Aqua-Lab-Boat-Team/WN-sensor_board/sensor_board.kicad_pcb

## KiCad design sensor_board.kicad_pcb (2026-11-14)

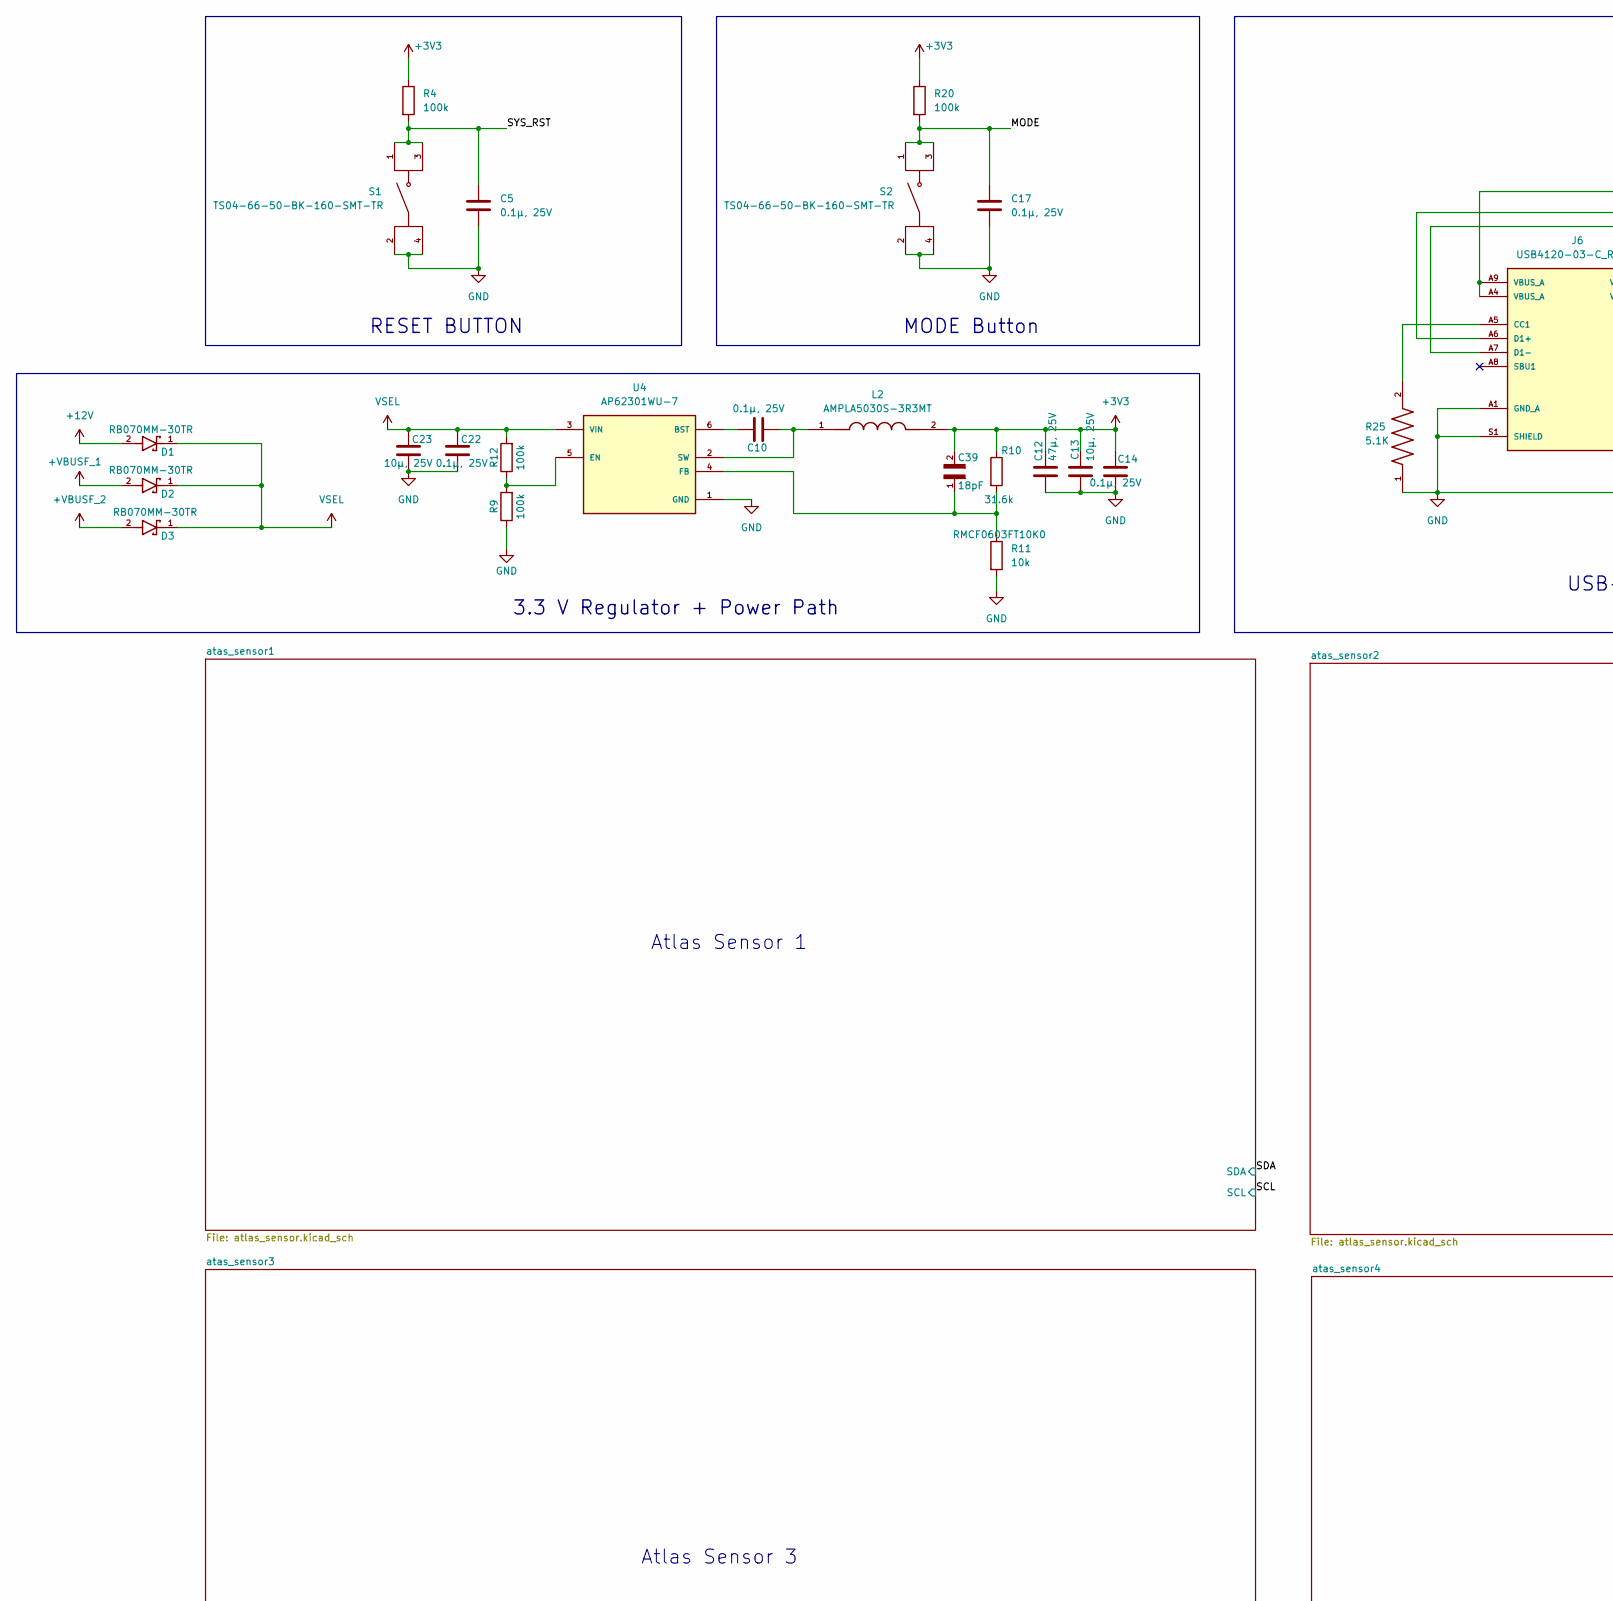
[picture p1: schematic sensor_board.kicad_sch, part in row 1, column 1]

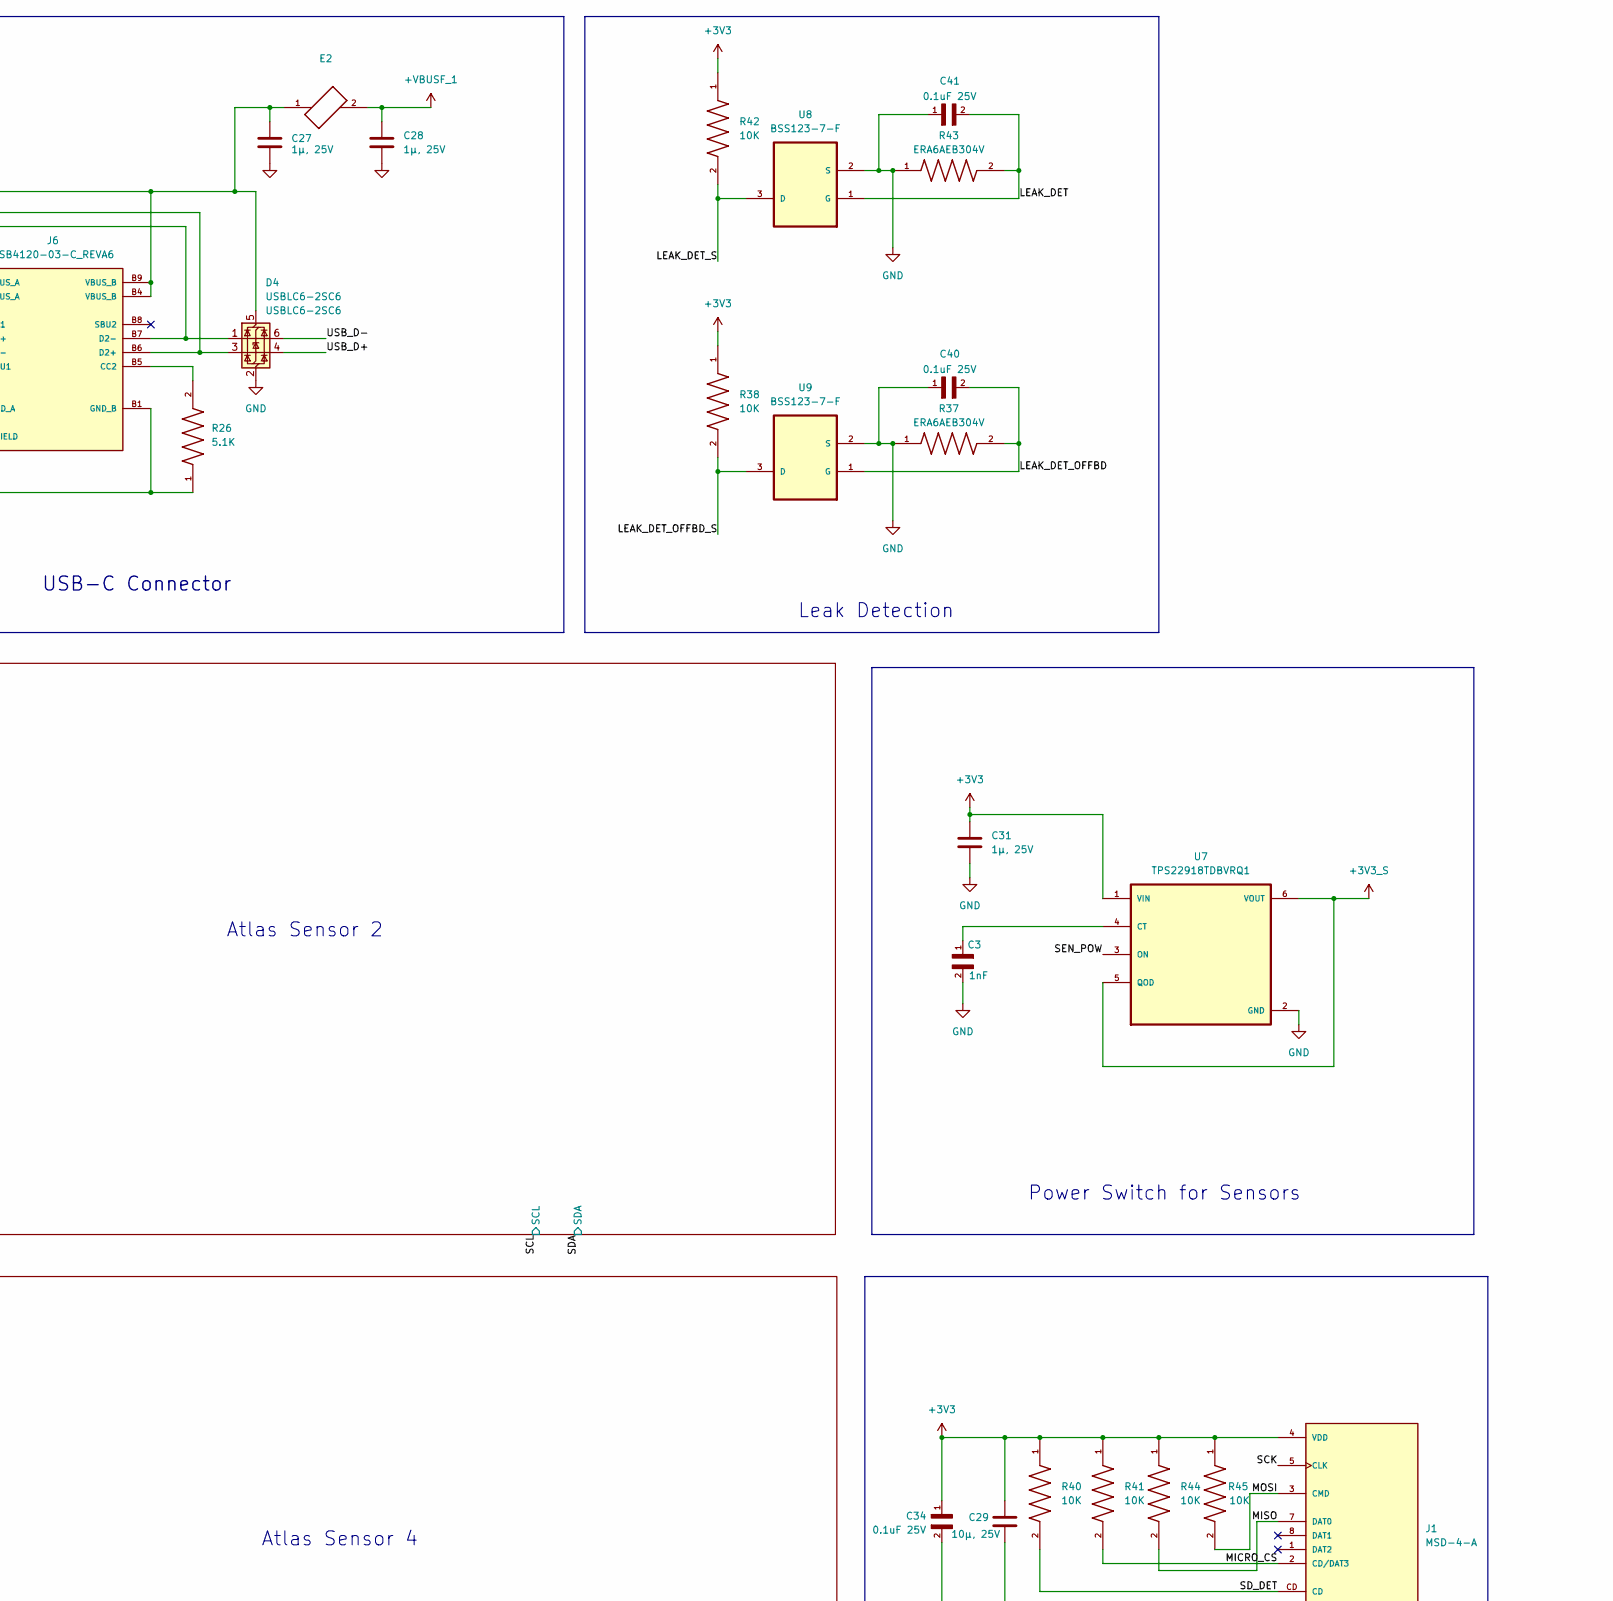
[picture p2: schematic sensor_board.kicad_sch, part in row 1, column 2]

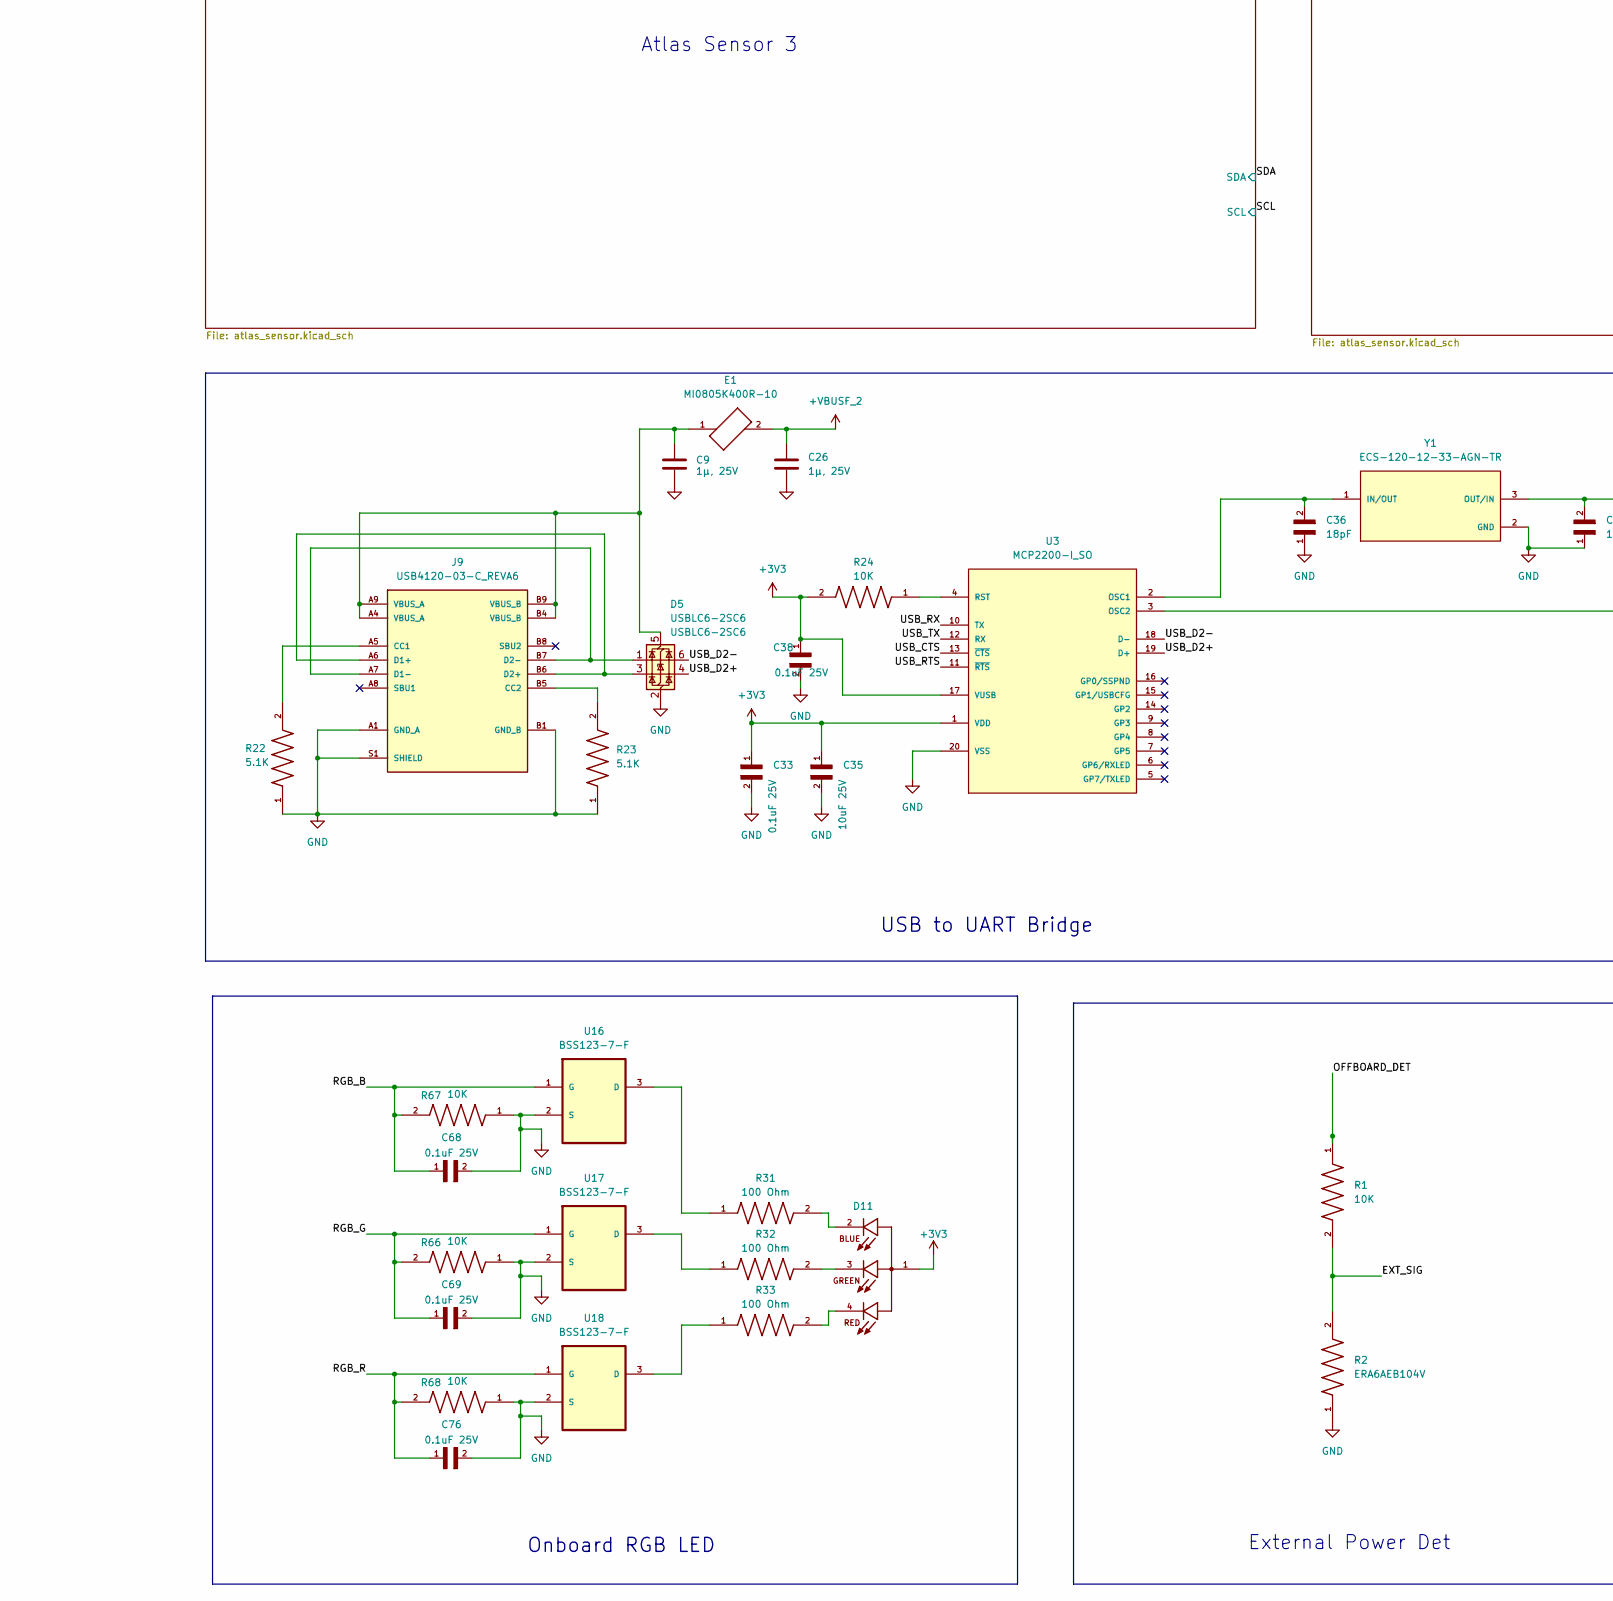
[picture p3: schematic sensor_board.kicad_sch, part in row 2, column 1]

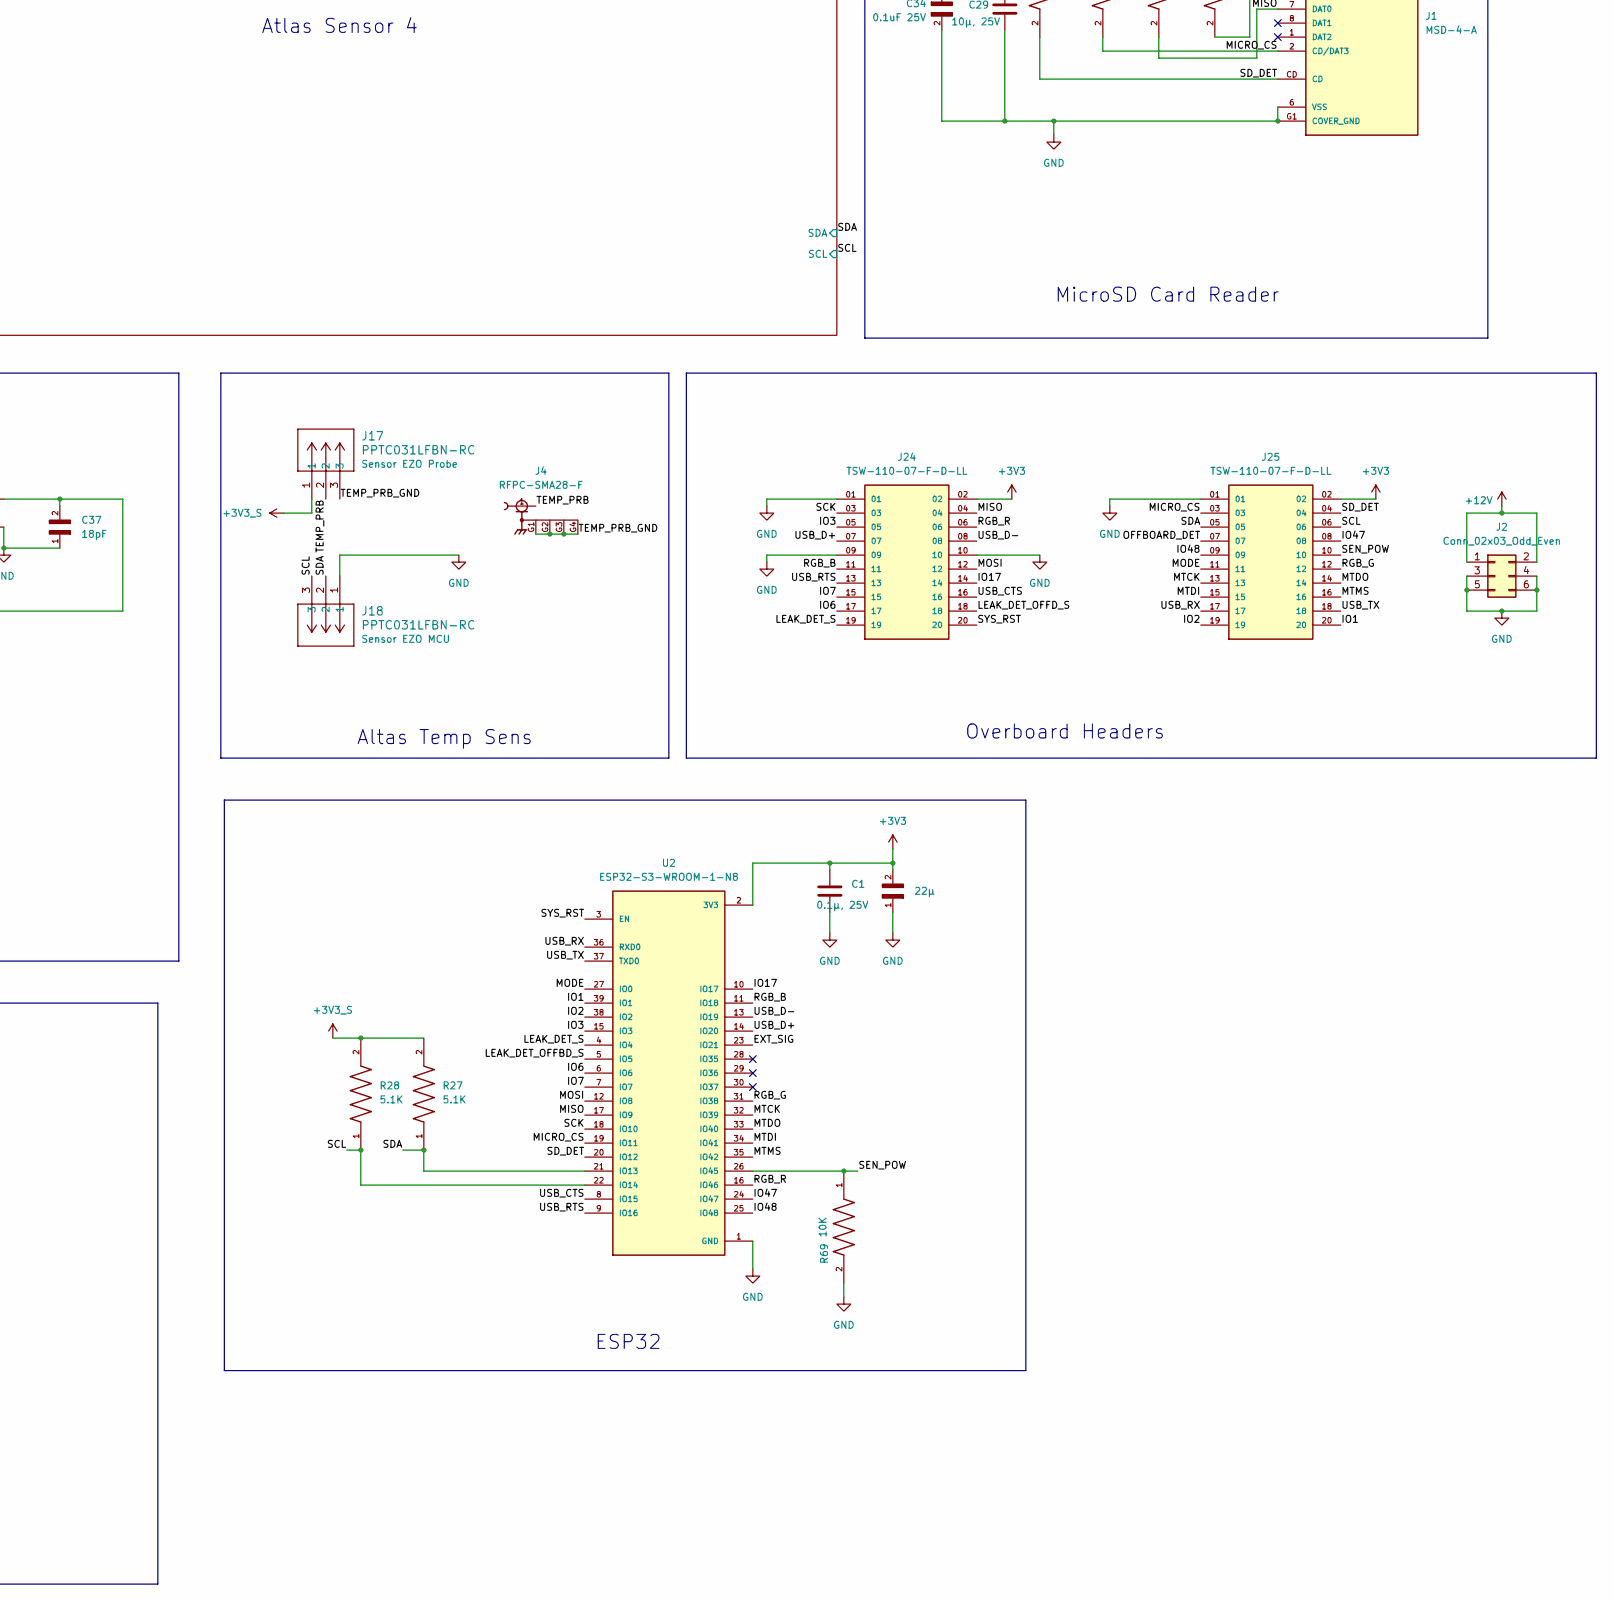
[picture p4: schematic sensor_board.kicad_sch, part in row 2, column 2]

Parts:
C1, C5, C10, C14, C17, C22: 0.1µ, 25V; CAPC2012X95N
C2: 22µ; CAPC1608X105N
C3: 1nF; CAPC1608X90
C9, C26, C27, C28, C31: 1µ, 25V; CAPC2012X145N
C12: 47µ, 25V; CAPC3216X180N
C13, C23, C29: 10µ, 25V; CAPC2012X145N
C33, C34, C38, C40, C41, C68, C69, C76: 0.1uF 25V; CAPC2012X95N
C35: 10uF 25V; CAPC2012X145N
C36, C37, C39: 18pF; CAPC1608X90N
D1, D2, D3: RB070MM-30TR; DIO_RB070MM-30TR
D4, D5: USBLC6-2SC6; SOT-23-6
D11: CLMVC-FKA-CL1D1L71BB7C3C3; LED_CLMVC-FKA-CL1D1L71BB7C3C3; PARTREV 14
E1, E2: MI0805K400R-10; FB_MI0805K400R-10
J1: MSD-4-A; CUI_MSD-4-A; PARTREV 1.0
J2: Conn_02x03_Odd_Even; SULLINS_PPTC032LFBN-RC
J4: RFPC-SMA28-F; GRADCONN_RFPC-SMA28-F; PARTREV 1.0
J6, J9: USB4120-03-C_REVA6; GCT_USB4120-03-C_REVA6; PARTREV A6
J17, J18: PPTC031LFBN-RC; CONN_PPTC031_SUL
J24, J25: TSW-110-07-F-D-LL; SAMTEC_TSW-110-07-F-D-LL; PARTREV R
L2: AMPLA5030S-3R3MT; IND_AMPLA5030S-3R3MT; PARTREV 9/23/2019
R1, R24, R38, R40, R41, R42, R44, R45, R66, R67, R68, R69: 10K; RES_ERA6AEB103V; PARTREV 3/1/2020
R2: ERA6AEB104V; RES_ERA6AEB104V; PARTREV 3/1/2020
R4, R9, R12, R20: 100k; RES_ERA6AEB104V
R10: 31.6k; RES_ERA6AEB3162V
R11: 10k; RES_ERA6AEB103V
R22, R23, R25, R26, R27, R28: 5.1K; RESC1508X55N
R31, R32, R33: 100 Ohm; RES_ERJ3EKF1000V; PARTREV 3/1/2020
R37, R43: ERA6AEB304V; RES_ERA6AEB304V; PARTREV 3/1/2020
S1, S2: TS04-66-50-BK-160-SMT-TR; SW_TS04-66-50-BK-160-SMT-TR; PARTREV 1.04mm
U2: ESP32-S3-WROOM-1-N8; XCVR_ESP32-S3-WROOM-1-N8
U3: MCP2200-I_SO; SOIC20; MANUFACTURER_PART_NUMBER mcp2200-i/so
U4: AP62301WU-7; SOT95P280X100-6N; PARTREV Rev. 3 - 2
U7: TPS22918TDBVRQ1; SOT95P280X145-6N
U8, U9, U16, U17, U18: BSS123-7-F; SOT95P240X110-3N; MPN BSS123-7-F
Y1: ECS-120-12-33-AGN-TR; XTAL_ECS-120-12-33-AGN-TR

Connections:
+3V3: C1.1, C2.2, C12.1, C13.1, C14.1, C29.2, C31.1, C33.1, C34.1, C35.1, C38.1, C39.2, D11.1, J1.4 (VDD), J24.02, J25.02, L2.2, R4.1, R10.1, R20.1, R24.2, R38.1, R40.1, R41.1, R42.1, R44.1, R45.1, U2.2 (3V3), U3.1 (VDD), U3.17 (VUSB), U7.1 (VIN)
+3V3_S: J17.1, R27.2, R28.2, U7.5 (QOD), U7.6 (VOUT); also elsewhere on the board
+12V: D1.2, J2.1, J2.2
+VBUSF_1: C28.1, D2.2, E2.2
+VBUSF_2: C26.1, D3.2, E1.2
/IO1: J25.20, U2.39 (IO1)
/IO2: J25.19, U2.38 (IO2)
/IO3: J24.05, U2.15 (IO3)
/IO6: J24.17, U2.6 (IO6)
/IO7: J24.15, U2.7 (IO7)
/IO17: J24.14, U2.10 (IO17)
/IO47: J25.08, U2.24 (IO47)
/IO48: J25.09, U2.25 (IO48)
/LEAK_DET: C41.2, R43.2, U8.1 (G)
/LEAK_DET_OFFBD: C40.2, R37.2, U9.1 (G)
/LEAK_DET_S: J24.19, R42.2, U2.4 (IO4), U8.3 (D)
/MICRO_CS: J1.2 (CD/DAT3), J25.03, R41.2, U2.19 (IO11)
/MISO: J1.7 (DAT0), J24.04, R44.2, U2.17 (IO9)
/MODE: C17.1, J25.11, R20.2, S2.1, S2.3, U2.27 (IO0)
/MOSI: J1.3 (CMD), J24.12, R45.2, U2.12 (IO8)
/MTCK: J25.13, U2.32 (IO39)
/MTDI: J25.15, U2.34 (IO41)
/MTDO: J25.14, U2.33 (IO40)
/MTMS: J25.16, U2.35 (IO42)
/RGB_B: C68.1, J24.11, R67.2, U2.11 (IO18), U16.1 (G)
/RGB_G: C69.1, J25.12, R66.2, U2.31 (IO38), U17.1 (G)
/RGB_R: C76.1, J24.06, R68.2, U2.16 (IO46), U18.1 (G)
/SCK: J1.5 (CLK), J24.03, U2.18 (IO10)
/SCL: J18.3, J25.06, R28.1, U2.22 (IO14); also elsewhere on the board
/SDA: J18.2, J25.05, R27.1, U2.21 (IO13); also elsewhere on the board
/SD_DET: J1.CD, J25.04, R40.2, U2.20 (IO12)
/SEN_POW: J25.10, R69.1, U2.26 (IO45), U7.3 (ON)
/SYS_RST: C5.1, J24.20, R4.2, S1.1, S1.3, U2.3 (EN)
/TEMP_PRB: J4.1, J17.2
/TEMP_PRB_GND: J4.G1, J4.G2, J4.G3, J4.G4, J17.3
/USB_CTS: J24.16, U2.8 (IO15), U3.13 (~CTS)
/USB_D2+: D5.4 (I/O2), U3.19 (D+)
/USB_D2-: D5.6 (I/O1), U3.18 (D-)
/USB_D+: D4.4 (I/O2), J24.07, U2.14 (IO20)
/USB_D-: D4.6 (I/O1), J24.08, U2.13 (IO19)
/USB_RTS: J24.13, U2.9 (IO16), U3.11 (~RTS)
/USB_RX: J25.17, U2.36 (RXD0), U3.10 (TX)
/USB_TX: J25.18, U2.37 (TXD0), U3.12 (RX)
GND: C1.2, C2.1, C3.2, C5.2, C9.2, C12.2, C13.2, C14.2, C17.2, C22.2, C23.2, C26.2, C27.2, C28.2, C29.1, C31.2, C33.2, C34.2, C35.2, C36.1, C37.1, C38.2, C40.1, C41.1, C68.2, C69.2, C76.2, D4.2 (GND), D5.2 (GND), J1.6 (VSS), J1.G1 (COVER_GND), J1.G2 (COVER_GND), J1.G3 (COVER_GND), J1.G4 (COVER_GND), J2.3, J2.4, J2.5, J2.6, J6.A1 (GND_A), J6.A12 (GND_A), J6.B1 (GND_B), J6.B12 (GND_B), J6.S1 (SHIELD), J6.S2 (SHIELD), J6.S3 (SHIELD), J6.S4 (SHIELD), J9.A1 (GND_A), J9.A12 (GND_A), J9.B1 (GND_B), J9.B12 (GND_B), J9.S1 (SHIELD), J9.S2 (SHIELD), J9.S3 (SHIELD), J9.S4 (SHIELD), J18.1, J24.01, J24.09, J24.10, J25.01, R2.1, R9.1, R11.2, R22.1, R23.1, R25.1, R26.1, R37.1, R43.1, R66.1, R67.1, R68.1, R69.2, S1.2, S1.4, S2.2, S2.4, U2.1 (GND), U2.40 (GND), U2.41, U2.41_1 (GND), U2.41_2 (GND), U2.41_3 (GND), U2.41_4 (GND), U2.41_5 (GND), U2.41_6 (GND), U2.41_7 (GND), U2.41_8 (GND), U2.41_9 (GND), U3.20 (VSS), U4.1 (GND), U7.2 (GND), U8.2 (S), U9.2 (S), U16.2 (S), U17.2 (S), U18.2 (S), Y1.2 (GND), Y1.4 (GND); also elsewhere on the board
unnamed: C27.1, D4.5 (VBUS), E2.1, J6.A4 (VBUS_A), J6.A9 (VBUS_A), J6.B4 (VBUS_B), J6.B9 (VBUS_B)
unnamed: C9.1, D5.5 (VBUS), E1.1, J9.A4 (VBUS_A), J9.A9 (VBUS_A), J9.B4 (VBUS_B), J9.B9 (VBUS_B)
unnamed: D11.2, R31.2
unnamed: D11.3, R32.2
unnamed: D11.4, R33.2
unnamed: J6.A5 (CC1), R25.2
unnamed: J6.B5 (CC2), R26.2
unnamed: D4.3 (I/O2), J6.A6 (D1+), J6.B6 (D2+)
unnamed: D4.1 (I/O1), J6.A7 (D1-), J6.B7 (D2-)
unnamed: J9.A5 (CC1), R22.2
unnamed: J9.B5 (CC2), R23.2
unnamed: D5.3 (I/O2), J9.A6 (D1+), J9.B6 (D2+)
unnamed: D5.1 (I/O1), J9.A7 (D1-), J9.B7 (D2-)
unnamed: C36.2, U3.2 (OSC1), Y1.1 (IN/OUT)
unnamed: C37.2, U3.3 (OSC2), Y1.3 (OUT/IN)
unnamed: R24.1, U3.4 (RST)
unnamed: C10.1, U4.6 (BST)
unnamed: R9.2, R12.1, U4.5 (EN)
unnamed: C39.1, R10.2, R11.1, U4.4 (FB)
unnamed: C10.2, L2.1, U4.2 (SW)
unnamed: C3.1, U7.4 (CT)
unnamed: R31.1, U16.3 (D)
unnamed: R32.1, U17.3 (D)
unnamed: R33.1, U18.3 (D)
VSEL: C22.1, C23.1, D1.1, D2.1, D3.1, R12.2, U4.3 (VIN)

Notes on the sheet:
USB-C Connector
Atlas Sensor 1
ESP32
Leak Detection
Overboard Headers
MODE Button
RESET BUTTON
Onboard RGB LED
MicroSD Card Reader
External Power Det
Atlas Sensor 4
Atlas Sensor 2
Altas Temp Sens
USB to UART Bridge
Power Switch for Sensors
3.3 V Regulator + Power Path
Atlas Sensor 3

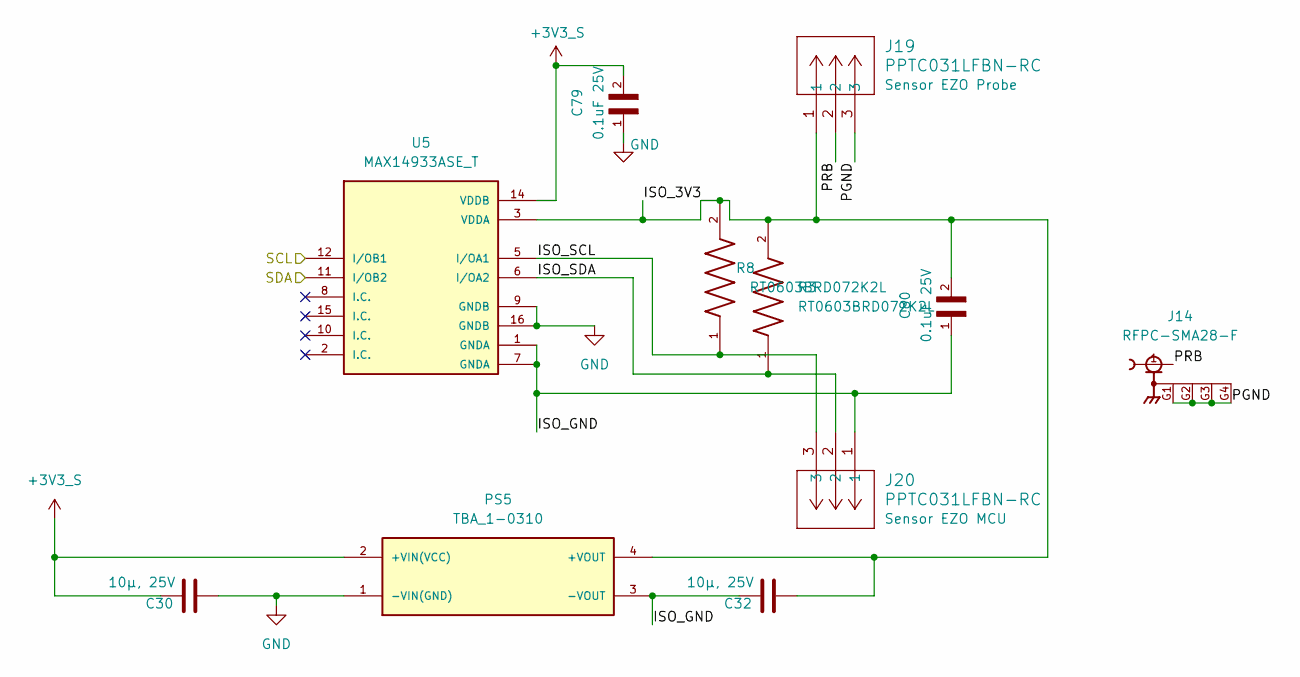
[picture p5: schematic atlas_sensor.kicad_sch]

Parts:
C30, C32: 10µ, 25V; CAPC2012X145N
C79, C80: 0.1uF 25V; CAPC2012X95N
J14: RFPC-SMA28-F; GRADCONN_RFPC-SMA28-F; PARTREV 1.0
J19, J20: PPTC031LFBN-RC; CONN_PPTC031_SUL
PS5: TBA_1-0310; CONV_TBA_1-0310; PARTREV April 19, 2021
R3, R8: RT0603BRD072K2L; RESC1608X55N
U5: MAX14933ASE_T; SOIC127P600X175-16N

Connections:
+3V3_S: C30.1, C79.2, PS5.2 (+VIN(VCC)), U5.14 (VDDB); also elsewhere on the board
/SCL: U5.12 (I/OB1); also elsewhere on the board
/SDA: U5.11 (I/OB2); also elsewhere on the board
/atas_sensor1/ISO_3V3: C32.2, C80.2, J19.1, PS5.4 (+VOUT), U5.3 (VDDA); also elsewhere on the board
/atas_sensor1/ISO_GND: C32.1, C80.1, J20.1, PS5.3 (-VOUT), U5.1 (GNDA), U5.7 (GNDA)
/atas_sensor1/ISO_SCL: J20.3, U5.5 (I/OA1); also elsewhere on the board
/atas_sensor1/ISO_SDA: J20.2, U5.6 (I/OA2); also elsewhere on the board
/atas_sensor1/PGND: J14.G1, J14.G2, J14.G3, J14.G4, J19.3
/atas_sensor1/PRB: J14.1, J19.2
GND: C30.2, C79.1, PS5.1 (-VIN(GND)), U5.9 (GNDB), U5.16 (GNDB); also elsewhere on the board

Parts of its further copies:
C42, C43, C44, C45, C46, C47: 10µ, 25V; CAPC2012X145N
C81, C82, C83, C84, C85, C86: 0.1uF 25V; CAPC2012X95N
J15, J16, J29: RFPC-SMA28-F; GRADCONN_RFPC-SMA28-F; PARTREV 1.0
J21, J22, J23, J26, J27, J28: PPTC031LFBN-RC; CONN_PPTC031_SUL
PS6, PS7, PS8: TBA_1-0310; CONV_TBA_1-0310; PARTREV April 19, 2021
U6, U10, U11: MAX14933ASE_T; SOIC127P600X175-16N

Connections of its further copies:
+3V3_S: C42.1, C44.1, C46.1, C81.2, C83.2, C85.2, PS6.2 (+VIN(VCC)), PS7.2 (+VIN(VCC)), PS8.2 (+VIN(VCC)), U6.14 (VDDB), U10.14 (VDDB), U11.14 (VDDB); also elsewhere on the board
/SCL: U6.12 (I/OB1), U10.12 (I/OB1), U11.12 (I/OB1); also elsewhere on the board
/SDA: U6.11 (I/OB2), U10.11 (I/OB2), U11.11 (I/OB2); also elsewhere on the board
/atas_sensor2/ISO_3V3: C47.2, C86.2, J27.1, PS8.4 (+VOUT), U11.3 (VDDA); also elsewhere on the board
/atas_sensor2/ISO_GND: C47.1, C86.1, J28.1, PS8.3 (-VOUT), U11.1 (GNDA), U11.7 (GNDA)
/atas_sensor2/ISO_SCL: J28.3, U11.5 (I/OA1); also elsewhere on the board
/atas_sensor2/ISO_SDA: J28.2, U11.6 (I/OA2); also elsewhere on the board
/atas_sensor2/PGND: J15.G1, J15.G2, J15.G3, J15.G4, J27.3
/atas_sensor2/PRB: J15.1, J27.2
/atas_sensor3/ISO_3V3: C43.2, C82.2, J21.1, PS6.4 (+VOUT), U6.3 (VDDA); also elsewhere on the board
/atas_sensor3/ISO_GND: C43.1, C82.1, J22.1, PS6.3 (-VOUT), U6.1 (GNDA), U6.7 (GNDA)
/atas_sensor3/ISO_SCL: J22.3, U6.5 (I/OA1); also elsewhere on the board
/atas_sensor3/ISO_SDA: J22.2, U6.6 (I/OA2); also elsewhere on the board
/atas_sensor3/PGND: J16.G1, J16.G2, J16.G3, J16.G4, J21.3
/atas_sensor3/PRB: J16.1, J21.2
/atas_sensor4/ISO_3V3: C45.2, C84.2, J23.1, PS7.4 (+VOUT), U10.3 (VDDA); also elsewhere on the board
/atas_sensor4/ISO_GND: C45.1, C84.1, J26.1, PS7.3 (-VOUT), U10.1 (GNDA), U10.7 (GNDA)
/atas_sensor4/ISO_SCL: J26.3, U10.5 (I/OA1); also elsewhere on the board
/atas_sensor4/ISO_SDA: J26.2, U10.6 (I/OA2); also elsewhere on the board
/atas_sensor4/PGND: J23.3, J29.G1, J29.G2, J29.G3, J29.G4
/atas_sensor4/PRB: J23.2, J29.1
GND: C42.2, C44.2, C46.2, C81.1, C83.1, C85.1, PS6.1 (-VIN(GND)), PS7.1 (-VIN(GND)), PS8.1 (-VIN(GND)), U6.9 (GNDB), U6.16 (GNDB), U10.9 (GNDB), U10.16 (GNDB), U11.9 (GNDB), U11.16 (GNDB); also elsewhere on the board

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
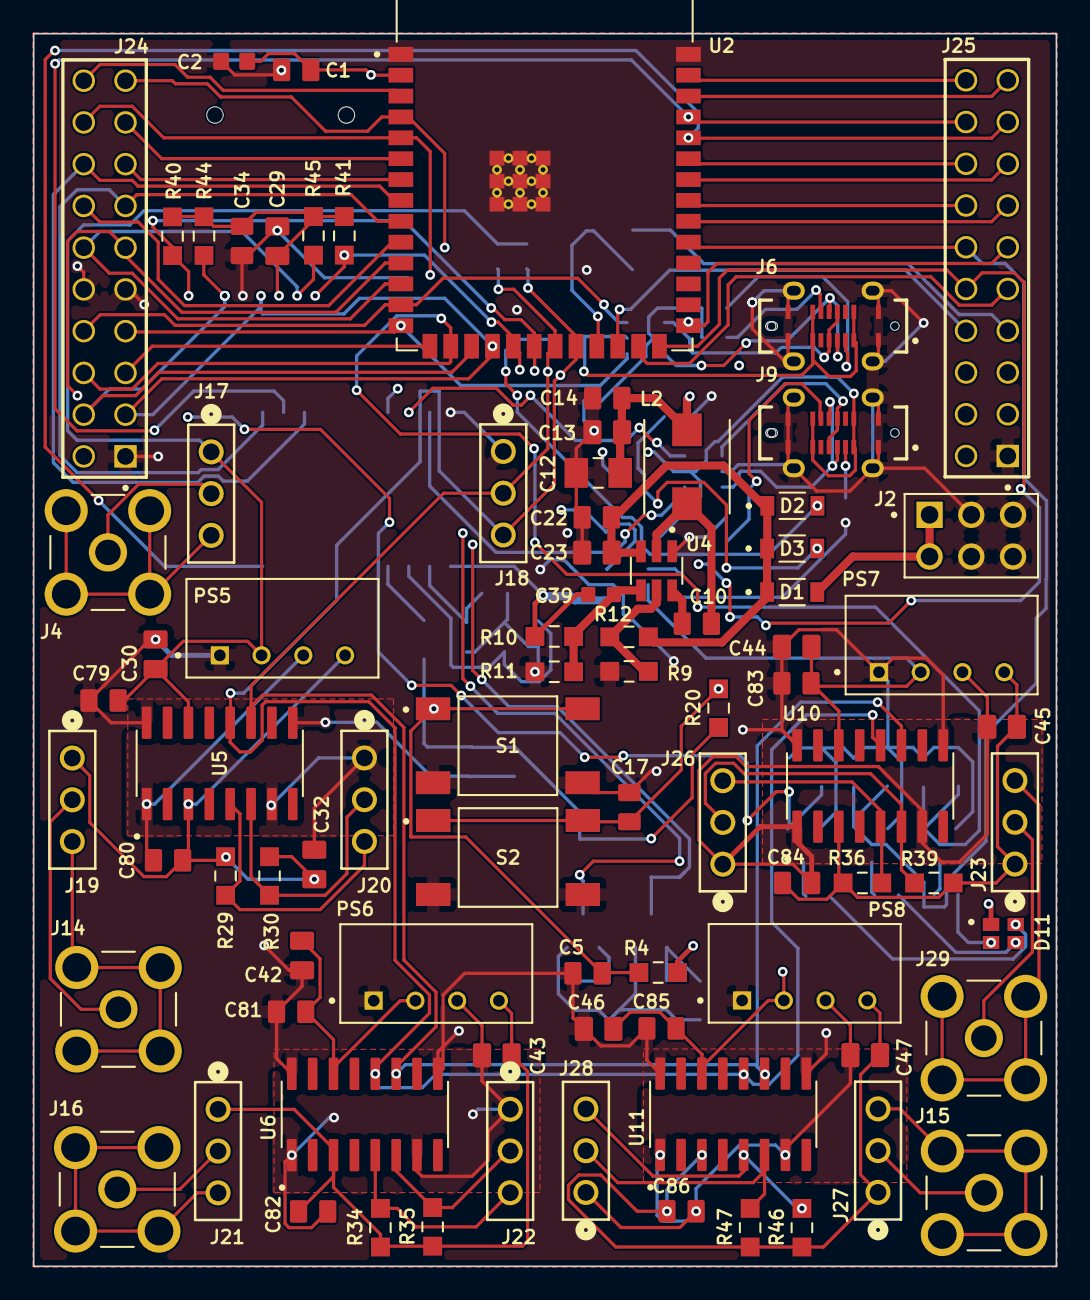
[picture p6: board sensor_board.kicad_pcb from above]

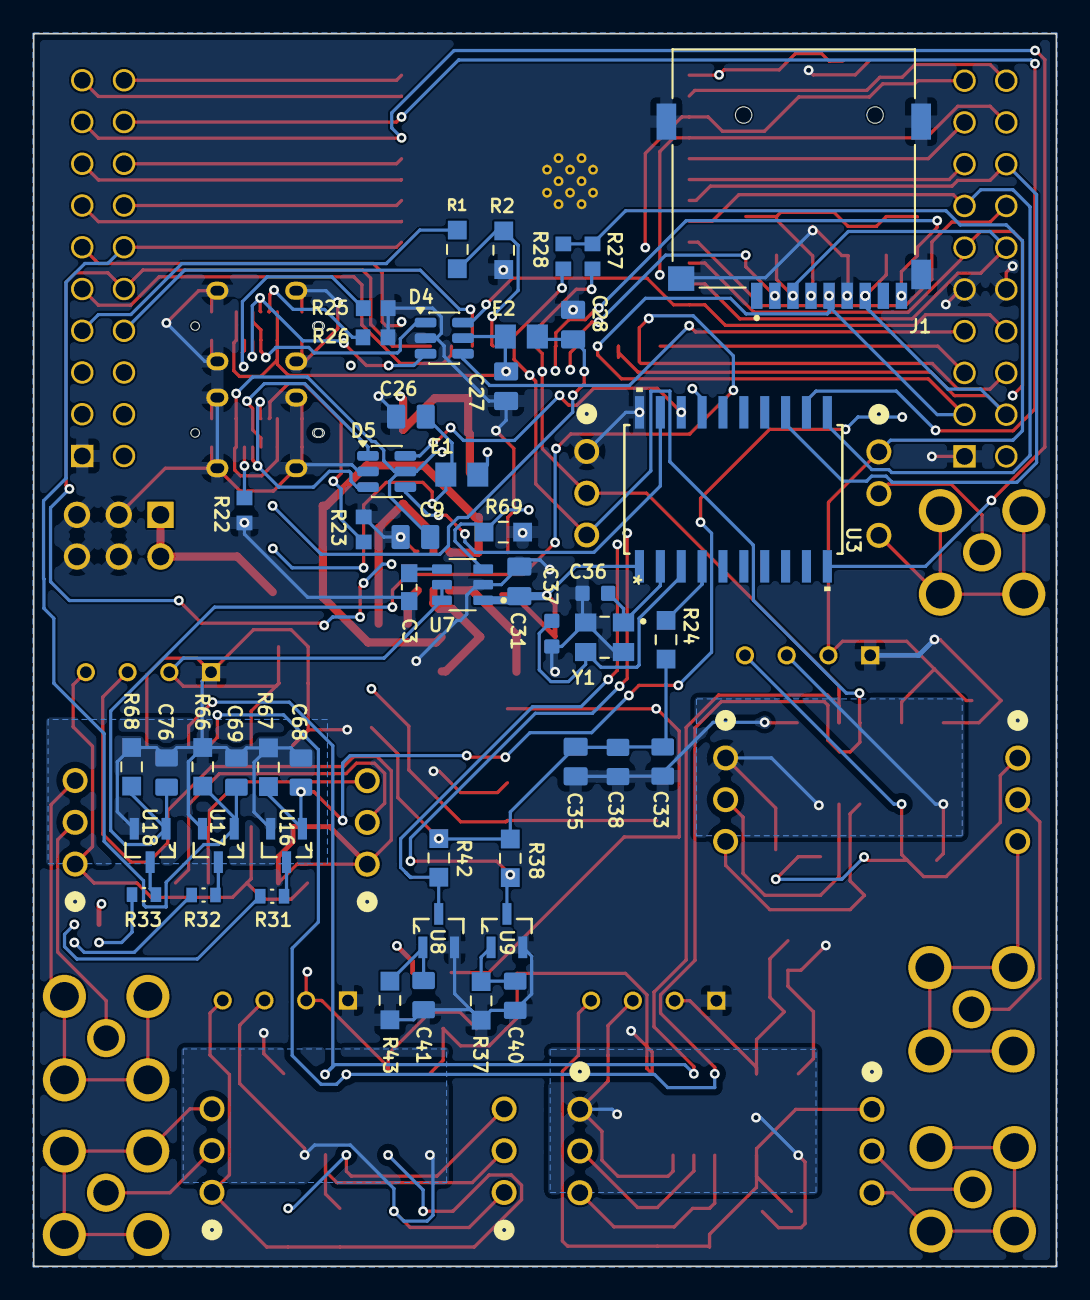
[picture p7: board sensor_board.kicad_pcb from below]

Board: 4 copper layers, 62.2 x 75.0 mm, 133 parts (49 on the bottom side), 96 nets.

Other parts of the board:
R29, R30, R34, R35, R36, R39, R46, R47: 10k; RES_ERA6AEB103V

Their connections:
/atas_sensor1/ISO_3V3: R29.1, R30.1; also elsewhere on the board
/atas_sensor1/ISO_SCL: R29.2; also elsewhere on the board
/atas_sensor1/ISO_SDA: R30.2; also elsewhere on the board
/atas_sensor2/ISO_3V3: R46.1, R47.1; also elsewhere on the board
/atas_sensor2/ISO_SCL: R46.2; also elsewhere on the board
/atas_sensor2/ISO_SDA: R47.2; also elsewhere on the board
/atas_sensor3/ISO_3V3: R34.1, R35.1; also elsewhere on the board
/atas_sensor3/ISO_SCL: R34.2; also elsewhere on the board
/atas_sensor3/ISO_SDA: R35.2; also elsewhere on the board
/atas_sensor4/ISO_3V3: R36.1, R39.1; also elsewhere on the board
/atas_sensor4/ISO_SCL: R36.2; also elsewhere on the board
/atas_sensor4/ISO_SDA: R39.2; also elsewhere on the board
