Aqua-Lab-Boat-Team/WN-sensor_board/sensor_board 2.kicad_pcb

## KiCad design sensor_board 2.kicad_pcb (2026-10-06)

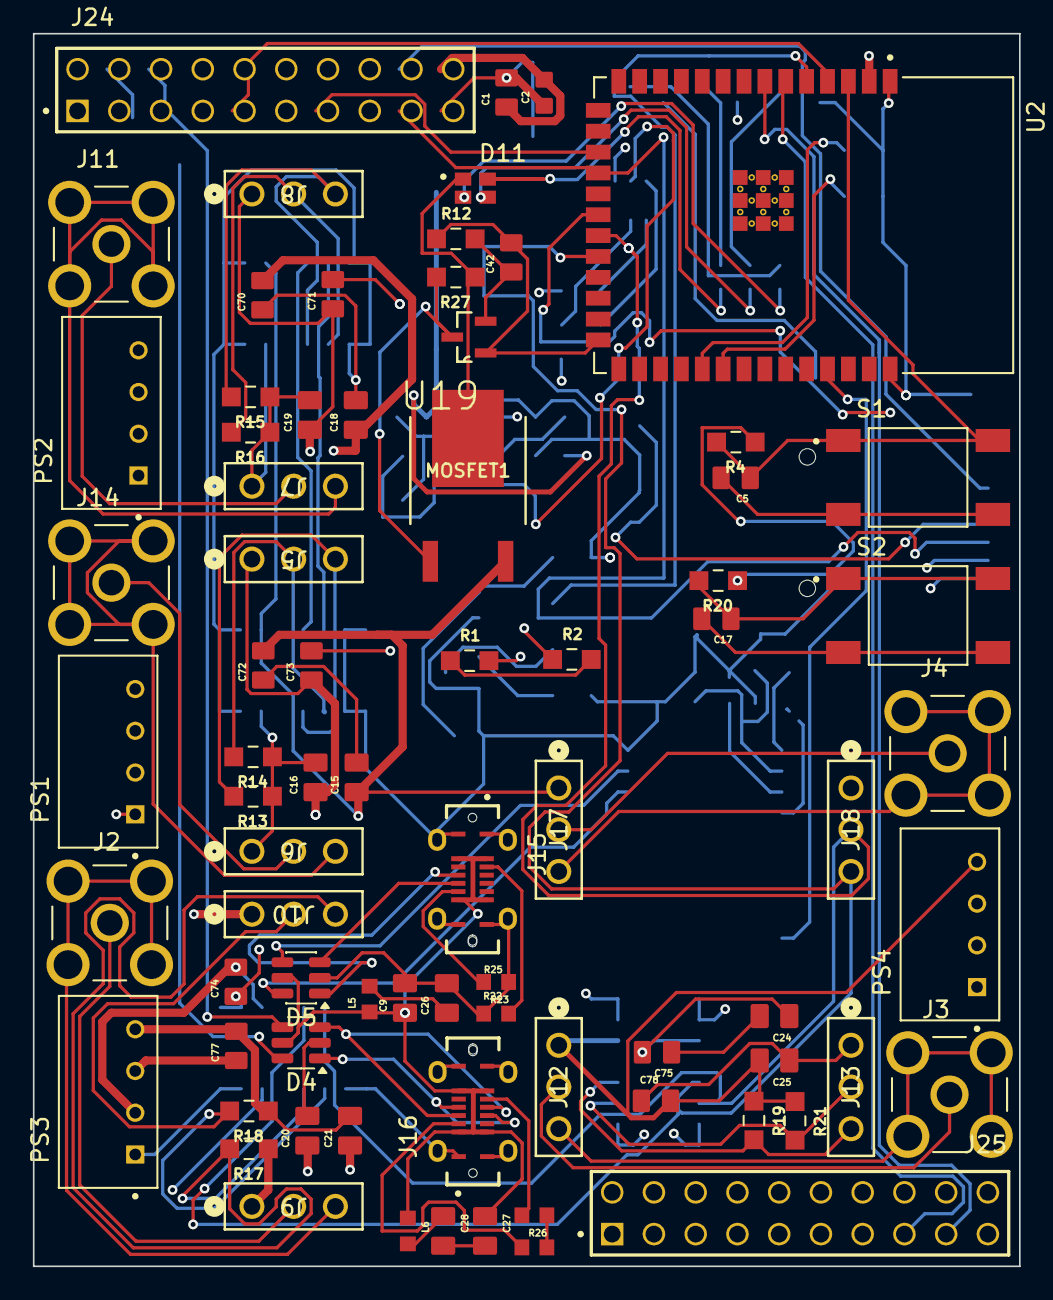
[picture p8: board sensor_board 2.kicad_pcb from above]

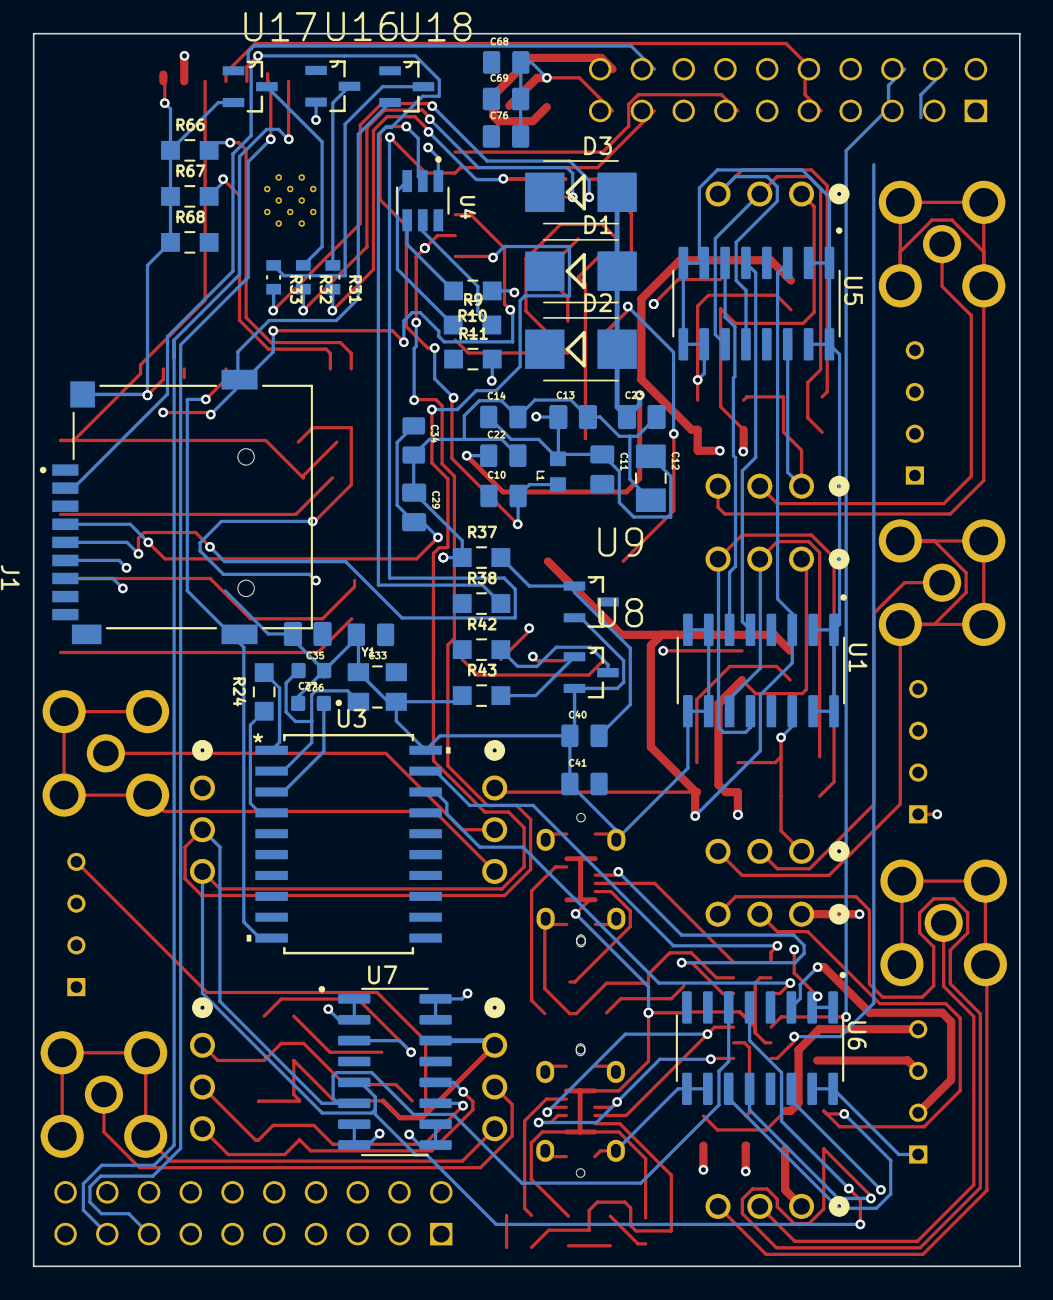
[picture p9: board sensor_board 2.kicad_pcb from below]

Board: 4 copper layers, 60.0 x 75.0 mm, 125 parts (49 on the bottom side), 95 nets.

Parts:
C1, C5, C10, C14, C17, C22: 0.1µ, 25V; CAPC2012X95N
C2: 22µ; CAPC1608X105N
C9, C26, C27, C28: 1µ, 25V; CAPC2012X145N
C11, C13, C15, C16, C18, C19, C20, C21, C23, C24, C25, C29: 10µ, 25V; CAPC2012X145N
C12: 47µ, 25V; CAPC3216X180N
C33, C34, C40, C41, C42, C68, C69, C70, C71, C72, C73, C74, C75, C76, C77, C78: 0.1uF 25V; CAPC2012X95N
C35: 10uF 25V; CAPC2012X145N
C36, C37: 18pF; CAPC1608X90N
D1, D2, D3: RB070MM-30TR; SMB
D4, D5: USBLC6-2SC6; SOT-23-6
D11: CLMVC-FKA-CL1D1L71BB7C3C3; LED_CLMVC-FKA-CL1D1L71BB7C3C3
J1: MSD-4-A; CUI_MSD-4-A
J2, J3, J4, J11, J14: RFPC-SMA28-F; GRADCONN_RFPC-SMA28-F
J5, J6, J7, J8, J9, J10, J12, J13, J17, J18: PPTC031LFBN-RC; CONN_PPTC031_SUL
J15, J16: USB4120-03-C_REVA6; GCT_USB4120-03-C_REVA6
J24, J25: TSW-110-07-F-D-LL; SAMTEC_TSW-110-07-F-D-LL
L1, L5, L6: 3.3µ; INDC1608X95N
MOSFET1: IRFR5505TRPBF; PG-TO252AA_INF
PS1, PS2, PS3, PS4: TBA_1-0310; CONV_TBA_1-0310
R1, R2: ERA6AEB104V; RES_ERA6AEB104V
R4, R9, R20: 100k; RES_ERA6AEB104V
R10: 31.6k; RES_ERA6AEB3162V
R11, R12, R13, R14, R15, R16, R17, R18, R19, R21, R27: 10k; RES_ERA6AEB103V
R22, R23, R25, R26: 5.1K; RESC1508X55N
R24, R38, R42, R66, R67, R68: 10K; RES_ERA6AEB103V
R31, R32, R33: 100 Ohm; RES_ERJ3EKF1000V
R37, R43: ERA6AEB304V; RES_ERA6AEB304V
S1, S2: TS04-66-50-BK-160-SMT-TR; SW_TS04-66-50-BK-160-SMT-TR
U1, U5, U6, U7: MAX14933ASE_T; SOIC127P600X175-16N
U2: ESP32-S3-WROOM-1-N8; XCVR_ESP32-S3-WROOM-1-N8
U3: MCP2200-I_SO; SOIC20
U4: AP62301WU-7; SOT95P280X100-6N
U8, U9, U16, U17, U18, U19: BSS123-7-F; SOT95P240X110-3N
Y1: ECS-120-12-33-AGN-TR; XTAL_ECS-120-12-33-AGN-TR

Connections:
+3V3: C1.1, C2.2, C11.1, C12.1, C13.1, C14.1, C33.1, C35.1, D11.1, J24.20, J25.18, J25.20, L1.2, MOSFET1.2, R4.1, R10.1, R20.1, R24.2, R27.1, R38.1, R42.1, U2.2 (3V3), U3.1 (VDD)
+3V3_S: C15.1, C18.1, C20.1, C24.1, C70.2, C72.2, C74.2, C75.2, J17.1, MOSFET1.3, PS1.2 (+VIN(VCC)), PS2.2 (+VIN(VCC)), PS3.2 (+VIN(VCC)), PS4.2 (+VIN(VCC)), U1.3 (VDDA), U5.3 (VDDA), U6.3 (VDDA), U7.3 (VDDA)
+ISO_3V3_1: C16.2, C73.2, J6.1, PS1.4 (+VOUT), R13.1, R14.1, U1.14 (VDDB)
+ISO_3V3_2: C19.2, C71.2, J7.1, PS2.4 (+VOUT), R15.1, R16.1, U5.14 (VDDB), U6.14 (VDDB)
+ISO_3V3_3: C21.2, C77.2, J9.1, PS3.4 (+VOUT), R17.1, R18.1
+ISO_3V3_4: C25.2, C78.2, J12.1, PS4.4 (+VOUT), R19.1, R21.1, U7.14 (VDDB)
+VBUSF_1: C28.1, D2.1, L6.2
+VBUSF_2: C26.1, D3.1, L5.2, U3.17 (VUSB)
/CS: J1.2 (CD/DAT3), J24.18, U2.19 (IO11)
/EXT_SIG: J25.16, R1.2
/IO1: J25.09, U2.39 (IO1)
/IO2: J25.11, U2.38 (IO2)
/IO3: J25.13, U2.15 (IO3)
/IO6: J25.15, U2.6 (IO6)
/IO7: J25.17, U2.7 (IO7)
/IO17: J25.02, U2.10 (IO17)
/IO18: J25.04, U2.11 (IO18)
/IO40: J25.06, U2.33 (IO40)
/IO41: J25.08, U2.34 (IO41)
/IO42: J25.10, U2.35 (IO42)
/IO47: J25.12, U2.24 (IO47)
/IO48: J25.14, U2.25 (IO48)
/ISO_SCL_1: J5.3, R13.2, U1.12 (I/OB1)
/ISO_SCL_2: J8.3, R15.2, U5.12 (I/OB1)
/ISO_SCL_3: J10.3, R17.2, U6.12 (I/OB1)
/ISO_SCL_4: J13.3, R19.2, U7.12 (I/OB1)
/ISO_SDA_1: J5.2, R14.2, U1.11 (I/OB2)
/ISO_SDA_2: J8.2, R16.2, U5.11 (I/OB2)
/ISO_SDA_3: J10.2, R18.2, U6.11 (I/OB2)
/ISO_SDA_4: J13.2, R21.2, U7.11 (I/OB2)
/LEAK_DET: C41.2, R43.2, U8.1 (G)
/LEAK_DET_OFFBD: C40.2, R37.2, U9.1 (G)
/LEAK_DET_OFFBD_S: J24.11, R38.2, U2.5 (IO5), U9.3 (D)
/LEAK_DET_S: J24.09, R42.2, U2.4 (IO4), U8.3 (D)
/MISO: J1.7 (DAT0), J24.13, U2.17 (IO9)
/MODE: C17.1, J24.03, R20.2, S2.1, S2.3, U2.27 (IO0)
/MOSI: J1.3 (CMD), J24.15, U2.12 (IO8)
/OFFBOARD_DET: J24.16, R1.1, R2.2, U2.23 (IO21)
/PGND1: J6.3, J14.G1, J14.G2, J14.G3, J14.G4
/PGND2: J7.3, J11.G1, J11.G2, J11.G3, J11.G4
/PGND3: J2.G1, J2.G2, J2.G3, J2.G4, J9.3
/PGND4: J3.G1, J3.G2, J3.G3, J3.G4, J12.3
/PRB1: J6.2, J14.1
/PRB2: J7.2, J11.1
/PRB3: J2.1, J9.2
/PRB4: J3.1, J12.2
/RGB_B: C68.1, J25.03, R67.2, U2.32 (IO39), U16.1 (G)
/RGB_G: C69.1, J25.01, R66.2, U2.31 (IO38), U17.1 (G)
/RGB_R: C76.1, J25.05, R68.2, U2.16 (IO46), U18.1 (G)
/SCK: J1.5 (CLK), J24.17, U2.18 (IO10)
/SCL: J18.3, J24.10, U1.5 (I/OA1), U2.22 (IO14), U5.5 (I/OA1), U6.5 (I/OA1), U7.5 (I/OA1)
/SDA: J18.2, J24.12, U1.6 (I/OA2), U2.21 (IO13), U5.6 (I/OA2), U6.6 (I/OA2), U7.6 (I/OA2)
/SD_DET: J1.CD, J24.14, U2.20 (IO12)
/SEN_POW: C42.2, J25.07, R12.1, U2.26 (IO45), U19.1 (G)
/SYS_RST: C5.1, J24.01, R4.2, S1.1, S1.3, U2.3 (EN)
/TEMP_PRB: J4.1, J17.2
/TEMP_PRB_GND: J4.G1, J4.G2, J4.G3, J4.G4, J17.3
/USB_CTS: J24.02, U2.8 (IO15), U3.13 (~CTS)
/USB_D2+: D5.4 (I/O2), U3.19 (D+)
/USB_D2-: D5.6 (I/O1), U3.18 (D-)
/USB_D+: D4.4 (I/O2), J24.06, U2.14 (IO20)
/USB_D-: D4.6 (I/O1), J24.04, U2.13 (IO19)
/USB_RTS: J24.08, U2.9 (IO16), U3.11 (~RTS)
/USB_RX: J24.05, U2.36 (RXD0), U3.12 (RX)
/USB_TX: J24.07, U2.37 (TXD0), U3.10 (TX)
GND: C1.2, C2.1, C5.2, C9.2, C12.2, C13.2, C14.2, C15.2, C17.2, C18.2, C20.2, C22.2, C23.2, C24.2, C26.2, C27.2, C28.2, C29.1, C33.2, C34.2, C35.2, C36.1, C37.1, C40.1, C41.1, C42.1, C68.2, C69.2, C70.1, C72.1, C74.1, C75.1, C76.2, D4.2 (GND), D5.2 (GND), J1.6 (VSS), J1.G1 (COVER_GND), J1.G2 (COVER_GND), J1.G3 (COVER_GND), J1.G4 (COVER_GND), J15.A1 (GND_A), J15.A12 (GND_A), J15.B1 (GND_B), J15.B12 (GND_B), J15.S1 (SHIELD), J15.S2 (SHIELD), J15.S3 (SHIELD), J15.S4 (SHIELD), J16.A1 (GND_A), J16.A12 (GND_A), J16.B1 (GND_B), J16.B12 (GND_B), J16.S1 (SHIELD), J16.S2 (SHIELD), J16.S3 (SHIELD), J16.S4 (SHIELD), J18.1, J24.19, J25.19, PS1.1 (-VIN(GND)), PS2.1 (-VIN(GND)), PS3.1 (-VIN(GND)), PS4.1 (-VIN(GND)), R2.1, R11.2, R12.2, R22.1, R23.1, R25.1, R26.1, R37.1, R43.1, R66.1, R67.1, R68.1, S1.2, S1.4, S2.2, S2.4, U1.1 (GNDA), U1.2 (I.C.), U1.7 (GNDA), U1.8 (I.C.), U1.9 (GNDB), U1.10 (I.C.), U1.15 (I.C.), U1.16 (GNDB), U2.1 (GND), U2.40 (GND), U3.20 (VSS), U4.1 (GND), U5.1 (GNDA), U5.2 (I.C.), U5.7 (GNDA), U5.8 (I.C.), U5.9 (GNDB), U5.10 (I.C.), U5.15 (I.C.), U5.16 (GNDB), U6.1 (GNDA), U6.2 (I.C.), U6.7 (GNDA), U6.8 (I.C.), U6.9 (GNDB), U6.10 (I.C.), U6.15 (I.C.), U6.16 (GNDB), U7.1 (GNDA), U7.2 (I.C.), U7.7 (GNDA), U7.8 (I.C.), U7.9 (GNDB), U7.10 (I.C.), U7.15 (I.C.), U7.16 (GNDB), U8.2 (S), U9.2 (S), U16.2 (S), U17.2 (S), U18.2 (S), U19.2 (S), Y1.2 (GND), Y1.4 (GND)
ISO_GND_1: C16.1, C73.1, J5.1, PS1.3 (-VOUT)
ISO_GND_2: C19.1, C71.1, J8.1, PS2.3 (-VOUT)
ISO_GND_3: C21.1, C77.1, J10.1, PS3.3 (-VOUT)
ISO_GND_4: C25.1, C78.1, J13.1, PS4.3 (-VOUT)
unnamed: D11.2, R31.2
unnamed: D11.3, R32.2
unnamed: D11.4, R33.2
unnamed: C29.2, C34.1, J1.4 (VDD)
unnamed: J15.A5 (CC1), R22.2
unnamed: J15.B5 (CC2), R23.2
unnamed: D5.3 (I/O2), J15.A6 (D1+), J15.B6 (D2+)
unnamed: D5.1 (I/O1), J15.A7 (D1-), J15.B7 (D2-)
unnamed: J16.A5 (CC1), R25.2
unnamed: J16.B5 (CC2), R26.2
unnamed: D4.3 (I/O2), J16.A6 (D1+), J16.B6 (D2+)
unnamed: D4.1 (I/O1), J16.A7 (D1-), J16.B7 (D2-)
unnamed: C36.2, U3.2 (OSC1), Y1.1 (IN/OUT)
unnamed: C37.2, U3.3 (OSC2), Y1.3 (OUT/IN)
unnamed: R24.1, U3.4 (RST)
unnamed: C10.1, U4.6 (BST)
unnamed: R9.2, U4.5 (EN)
unnamed: C11.2, R10.2, R11.1, U4.4 (FB)
unnamed: C10.2, L1.1, U4.2 (SW)
unnamed: R31.1, U16.3 (D)
unnamed: R32.1, U17.3 (D)
unnamed: R33.1, U18.3 (D)
unnamed: MOSFET1.1, R27.2, U19.3 (D)
VBUS_A: C9.1, C27.1, D4.5 (VBUS), D5.5 (VBUS), J15.A4 (VBUS_A), J15.A9 (VBUS_A), J15.B4 (VBUS_B), J15.B9 (VBUS_B), J16.A4 (VBUS_A), J16.A9 (VBUS_A), J16.B4 (VBUS_B), J16.B9 (VBUS_B), L5.1, L6.1
VSEL: C22.1, C23.1, D1.2, D2.2, D3.2, R9.1, U4.3 (VIN)
