Aqua-Lab-Boat-Team/WN-sensor_board/(commit log)

2026-09-02 Sensor Board put into it's own repo
    [sensor_board.kicad_pcb, sensor_board.kicad_sch]
2026-09-06 Completed board layout
    [sensor_board.kicad_pcb, sensor_board.kicad_sch]
2026-09-09 Started tracing
    [sensor_board.kicad_sch]
2026-10-06 Overhauling design due to functionality and layout concerns
    [sensor_board 2.kicad_pcb, sensor_board.kicad_pcb, sensor_board.kicad_sch]
2026-11-08 Completed board layout and routing
    [atlas_sensor.kicad_sch, sensor_board.kicad_pcb, sensor_board.kicad_sch]
2026-11-11 Completed layout
    [sensor_board.kicad_pcb, sensor_board.kicad_sch]
2026-11-11 Add .gitignore and remove generated KiCad files
2026-11-14 Fixed silkscreen
    [atlas_sensor.kicad_sch, sensor_board.kicad_pcb]
