Aqua-Lab-Boat-Team/WN-sensor_board/(notices)

Notices in the files:
parts and their libraries:
COPYRIGHT: Copyright (C) 2023 Ultra Librarian. All rights reserved.
COPYRIGHT: Copyright (C) 2024 Ultra Librarian. All rights reserved.
